michaelyoyo/piDashHat/dashHat.kicad_pcb

## KiCad design dashHat.kicad_pcb (2024-06-26)

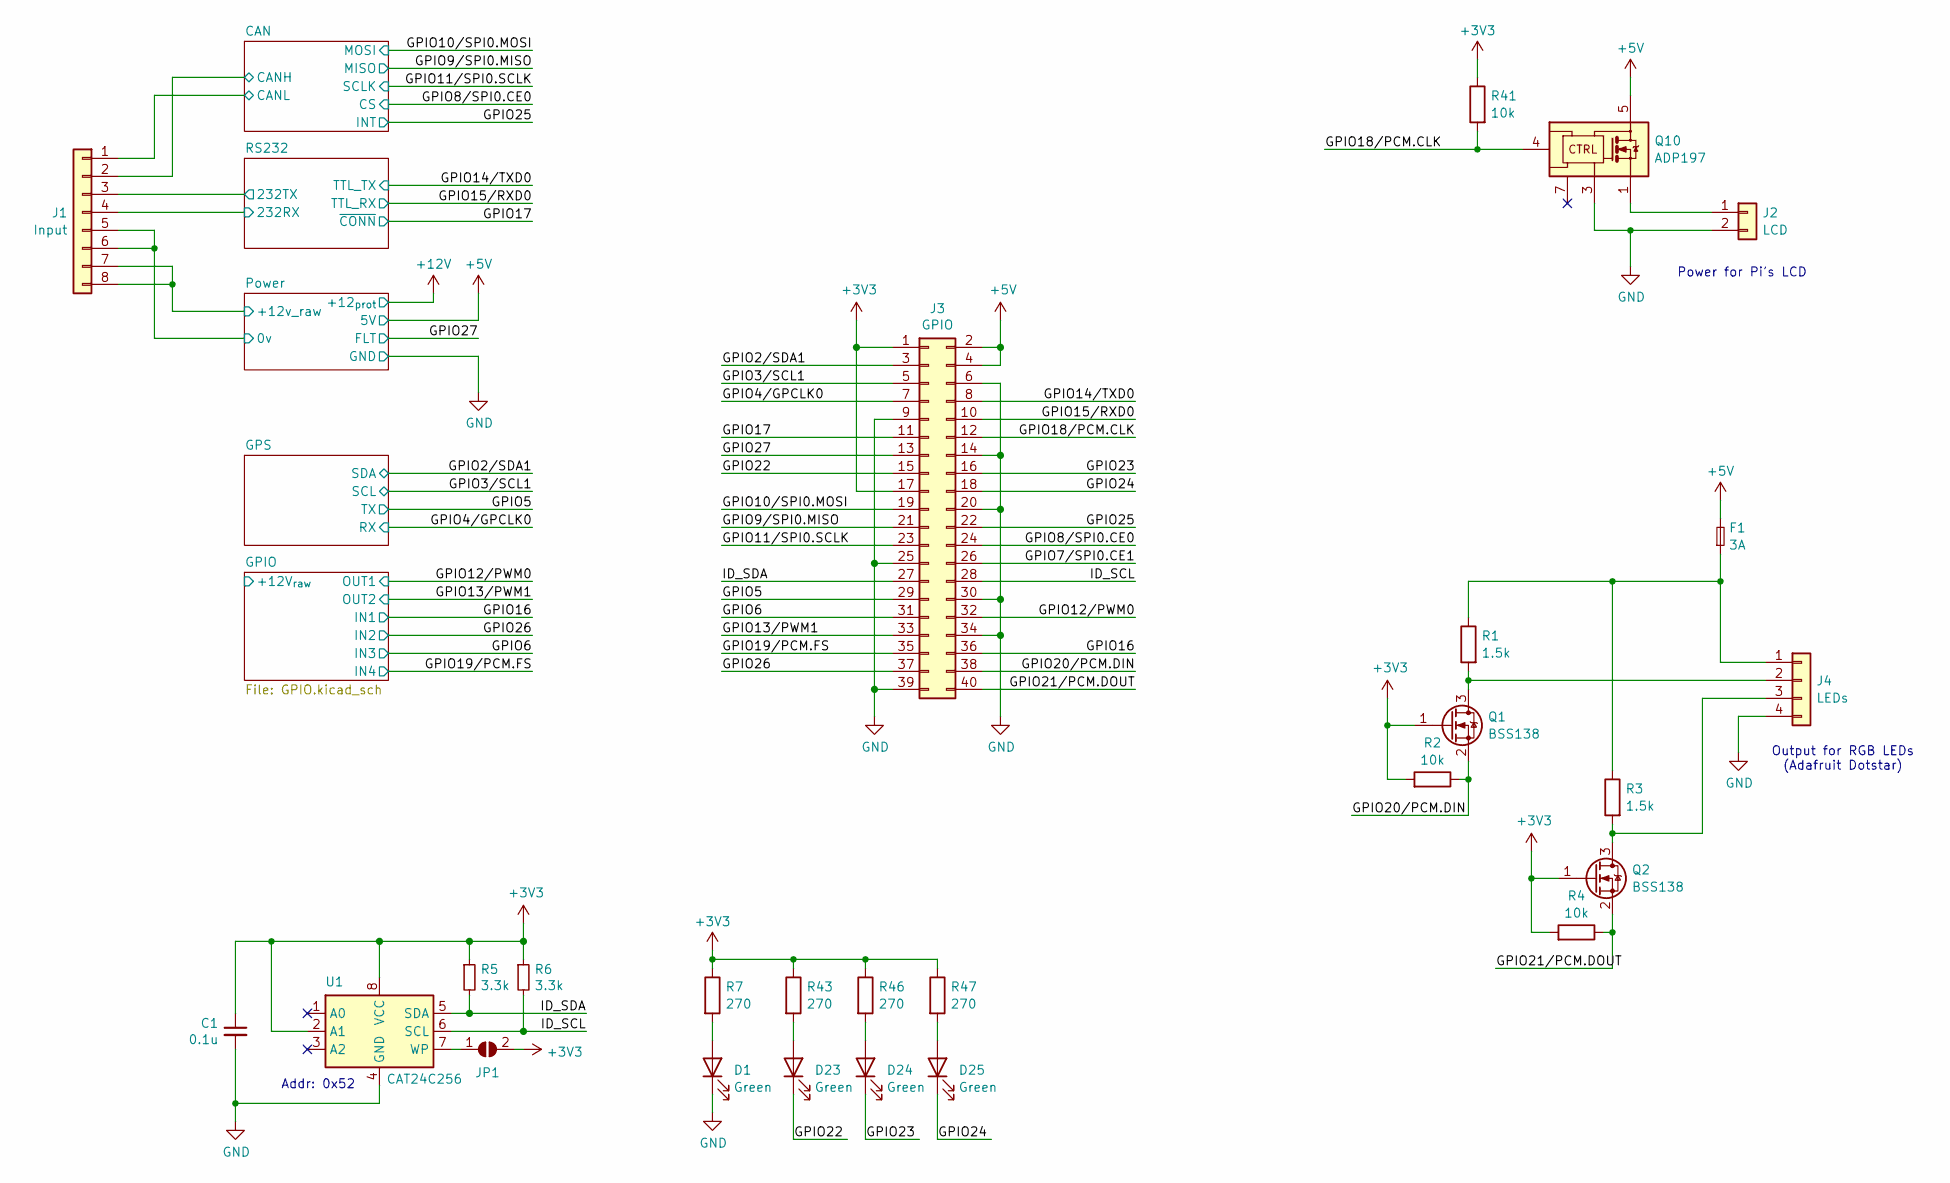
[picture p1: schematic dashHat.kicad_sch, PiDash HAT]

Parts:
C1: 0.1u; C_0603_1608Metric; Mfg Part Number CGA3E2X8R1E104K080AA
D1, D23, D24, D25: Green; LED_0603_1608Metric; Mfg Part Number HSMG-C190
F1: 3A; Fuse_1812_4532Metric; Mfg Part Number 0ZCG0260BF2B
J1: Input; Molex_Nano-Fit_105310-xx08_2x04_P2.50mm_Vertical; Mfg Part Number 105310-1108
J2: LCD; JST_XH_B2B-XH-A_1x02_P2.50mm_Vertical; Mfg Part Number --
J3: GPIO; PinSocket_2x20_P2.54mm_Vertical; Mfg Part Number SSQ-120-01-F-D
J4: LEDs; Molex_Nano-Fit_105310-xx04_2x02_P2.50mm_Vertical; Mfg Part Number 105310-1104
JP1: ID_WP; SolderJumper-2_P1.3mm_Open_RoundedPad1.0x1.5mm; Mfg Part Number --
Q1, Q2: BSS138; SOT-23; Mfg Part Number BSS138
Q10: ADP197; DFN-6-1EP_2x2mm_P0.65mm_EP1x1.6mm; Mfg Part Number ADP197ACPZN-01-R7
R1, R3: 1.5k; R_0603_1608Metric
R2, R4, R41: 10k; R_0603_1608Metric
R5, R6: 3.3k; R_0603_1608Metric
R7, R43, R46, R47: 270; R_0603_1608Metric
U1: CAT24C256; DFN-8-1EP_3x2mm_P0.5mm_EP1.36x1.46mm; Mfg Part Number CAT24C256HU4IGT3

Connections:
+3V3: C1.1, J3.1, J3.17, JP1.2 (B), Q1.1 (G), Q2.1 (G), R2.2, R4.2, R5.1, R6.1, R7.1, R41.1, R43.1, R46.1, R47.1, U1.2 (A1), U1.8 (VCC); also elsewhere on the board
+5V: F1.2, J3.2, J3.4, Q10.5 (VCC), Q10.6 (VCC); also elsewhere on the board
/CAN/CANH: J1.2; also elsewhere on the board
/CAN/CANL: J1.1; also elsewhere on the board
/GPIO2/SDA1: J3.3; also elsewhere on the board
/GPIO3/SCL1: J3.5; also elsewhere on the board
/GPIO4/GPCLK0: J3.7; also elsewhere on the board
/GPIO5: J3.29; also elsewhere on the board
/GPIO6: J3.31; also elsewhere on the board
/GPIO7/SPI0.CE1: J3.26
/GPIO8/SPI0.CE0: J3.24; also elsewhere on the board
/GPIO9/SPI0.MISO: J3.21; also elsewhere on the board
/GPIO10/SPI0.MOSI: J3.19; also elsewhere on the board
/GPIO11/SPI0.SCLK: J3.23; also elsewhere on the board
/GPIO12/PWM0: J3.32; also elsewhere on the board
/GPIO13/PWM1: J3.33; also elsewhere on the board
/GPIO14/TXD0: J3.8; also elsewhere on the board
/GPIO15/RXD0: J3.10; also elsewhere on the board
/GPIO16: J3.36; also elsewhere on the board
/GPIO17: J3.11; also elsewhere on the board
/GPIO18/PCM.CLK: J3.12, Q10.4 (EN), R41.2
/GPIO19/PCM.FS: J3.35; also elsewhere on the board
/GPIO20/PCM.DIN: J3.38, Q1.2 (S), R2.1
/GPIO21/PCM.DOUT: J3.40, Q2.2 (S), R4.1
/GPIO22: D23.1 (K), J3.15
/GPIO23: D24.1 (K), J3.16
/GPIO24: D25.1 (K), J3.18
/GPIO25: J3.22; also elsewhere on the board
/GPIO26: J3.37; also elsewhere on the board
/GPIO27: J3.13; also elsewhere on the board
/ID_SCL: J3.28, R6.2, U1.6 (SCL)
/ID_SDA: J3.27, R5.2, U1.5 (SDA)
/Power/+12v_raw: J1.7, J1.8; also elsewhere on the board
/RS232/232RX: J1.4; also elsewhere on the board
/RS232/232TX: J1.3; also elsewhere on the board
GND: C1.2, D1.1 (K), J1.5, J1.6, J2.2, J3.6, J3.9, J3.14, J3.20, J3.25, J3.30, J3.34, J3.39, J4.4, Q10.3 (GND), U1.4 (GND); also elsewhere on the board
unnamed: D1.2 (A), R7.2
unnamed: D23.2 (A), R43.2
unnamed: D24.2 (A), R46.2
unnamed: D25.2 (A), R47.2
unnamed: J2.1, Q10.1 (OUT), Q10.2 (OUT)
unnamed: F1.1, J4.1, R1.1, R3.1
unnamed: J4.2, Q1.3 (D), R1.2
unnamed: J4.3, Q2.3 (D), R3.2
unnamed: JP1.1 (A), U1.7 (WP)

Notes on the sheet:
Output for RGB LEDs (Adafruit Dotstar)
Addr: 0x52
Power for Pi's LCD

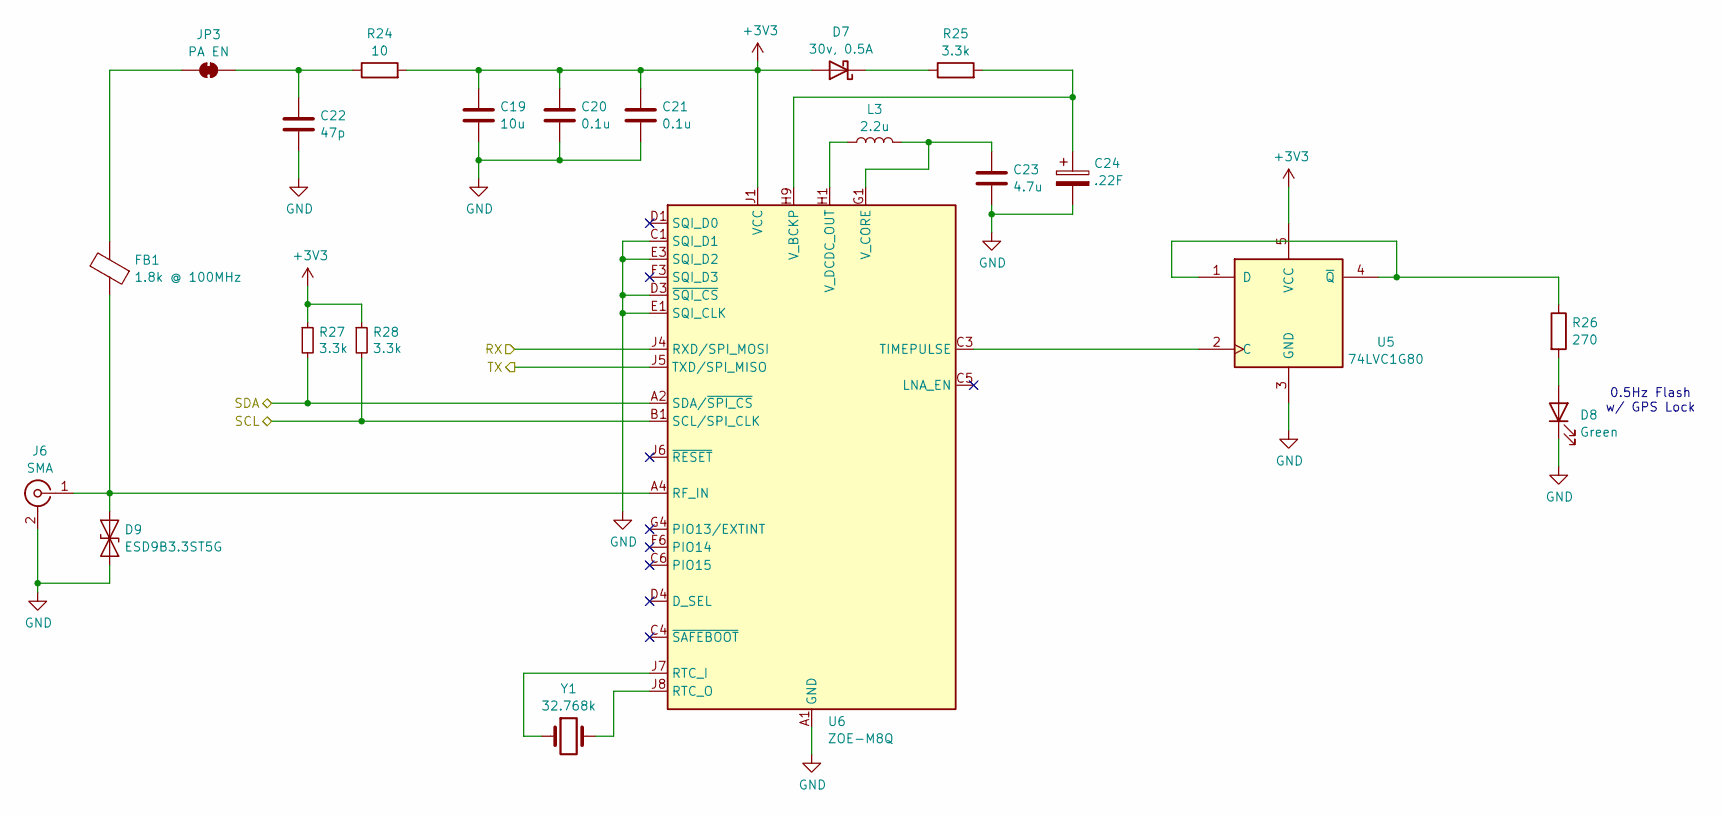
[picture p2: schematic gps.kicad_sch, PiDash HAT]

Parts:
C19: 10u; C_1206_3216Metric; Mfg Part Number CGA5L1X7R1C106K160AC
C20, C21: 0.1u; C_0603_1608Metric; Mfg Part Number CGA3E2X8R1E104K080AA
C22: 47p; C_0603_1608Metric; Mfg Part Number C0603C470K5RACAUTO
C23: 4.7u; C_0603_1608Metric; Mfg Part Number GCJ188C70J475KE02D
C24: .22F; DX_5R5HxxxxU_D11.5mm_P10.00mm; Mfg Part Number EDS224Z3R6H
D7: 30v, 0.5A; D_SOD-323HE; Mfg Part Number RSX051VYM30FHTR
D8: Green; LED_0603_1608Metric; Mfg Part Number HSMG-C190
D9: ESD9B3.3ST5G; D_SOD-923; Mfg Part Number ESD9R3.3ST5G
FB1: 1.8k @ 100MHz; L_0402_1005Metric; Mfg Part Number BLM15HD182SN1D
J6: SMA; SMA_Amphenol_132289_EdgeMount; Mfg Part Number 132289
JP3: PA EN; SolderJumper-2_P1.3mm_Open_RoundedPad1.0x1.5mm; Mfg Part Number --
L3: 2.2u; L_0806_2016Metric; Mfg Part Number LQM2MPN2R2NG0L
R24: 10; R_0603_1608Metric
R25, R27, R28: 3.3k; R_0603_1608Metric
R26: 270; R_0603_1608Metric
U5: 74LVC1G80; SOT-353_SC-70-5; Mfg Part Number 74LVC1G80GW,125
U6: ZOE-M8Q; ublox_ZOE_M8; Mfg Part Number ZOE-M8Q-0
Y1: 32.768k; Crystal_SMD_2012-2Pin_2.0x1.2mm; Mfg Part Number CM8V-T1A-32.768kHz-12.5pF-20PPM-TA-QC

Connections:
+3V3: C19.1, C20.1, C21.1, D7.2 (A), R24.2, R27.1, R28.1, U5.5 (VCC), U6.J1 (VCC), U6.J2 (VCC); also elsewhere on the board
/GPIO2/SDA1: R27.2, U6.A2 (SDA/~SPI_CS); also elsewhere on the board
/GPIO3/SCL1: R28.2, U6.B1 (SCL/SPI_CLK); also elsewhere on the board
/GPIO4/GPCLK0: U6.J4 (RXD/SPI_MOSI); also elsewhere on the board
/GPIO5: U6.J5 (TXD/SPI_MISO); also elsewhere on the board
GND: C19.2, C20.2, C21.2, C22.2, C23.2, C24.2, D8.1 (K), D9.1 (A1), J6.2 (Ext), U5.3 (GND), U6.A1 (GND), U6.A3 (GND), U6.A5 (GND), U6.A7 (GND), U6.A8 (GND), U6.A9 (GND), U6.B9 (GND), U6.C1 (SQI_D1), U6.C7 (GND), U6.C9 (GND), U6.D3 (~SQI_CS), U6.D6 (GND), U6.D9 (GND), U6.E1 (SQI_CLK), U6.E3 (SQI_D2), U6.E7 (GND), U6.F7 (GND), U6.G3 (GND), U6.G6 (GND), U6.G7 (GND), U6.J3 (GND), U6.J9 (GND); also elsewhere on the board
unnamed: D7.1 (K), R25.1
unnamed: D8.2 (A), R26.2
unnamed: D9.2 (A2), FB1.1, J6.1 (In), U6.A4 (RF_IN)
unnamed: C22.1, JP3.1 (A), R24.1
unnamed: FB1.2, JP3.2 (B)
unnamed: U5.2 (C), U6.C3 (TIMEPULSE)
unnamed: R26.1, U5.1 (D), U5.4 (~Q)
unnamed: U6.J7 (RTC_I), Y1.1
unnamed: U6.J8 (RTC_O), Y1.2
unnamed: C24.1, R25.2, U6.H9 (V_BCKP)
unnamed: C23.1, L3.2, U6.G1 (V_CORE)
unnamed: L3.1, U6.H1 (V_DCDC_OUT)

Notes on the sheet:
0.5Hz Flash w/ GPS Lock

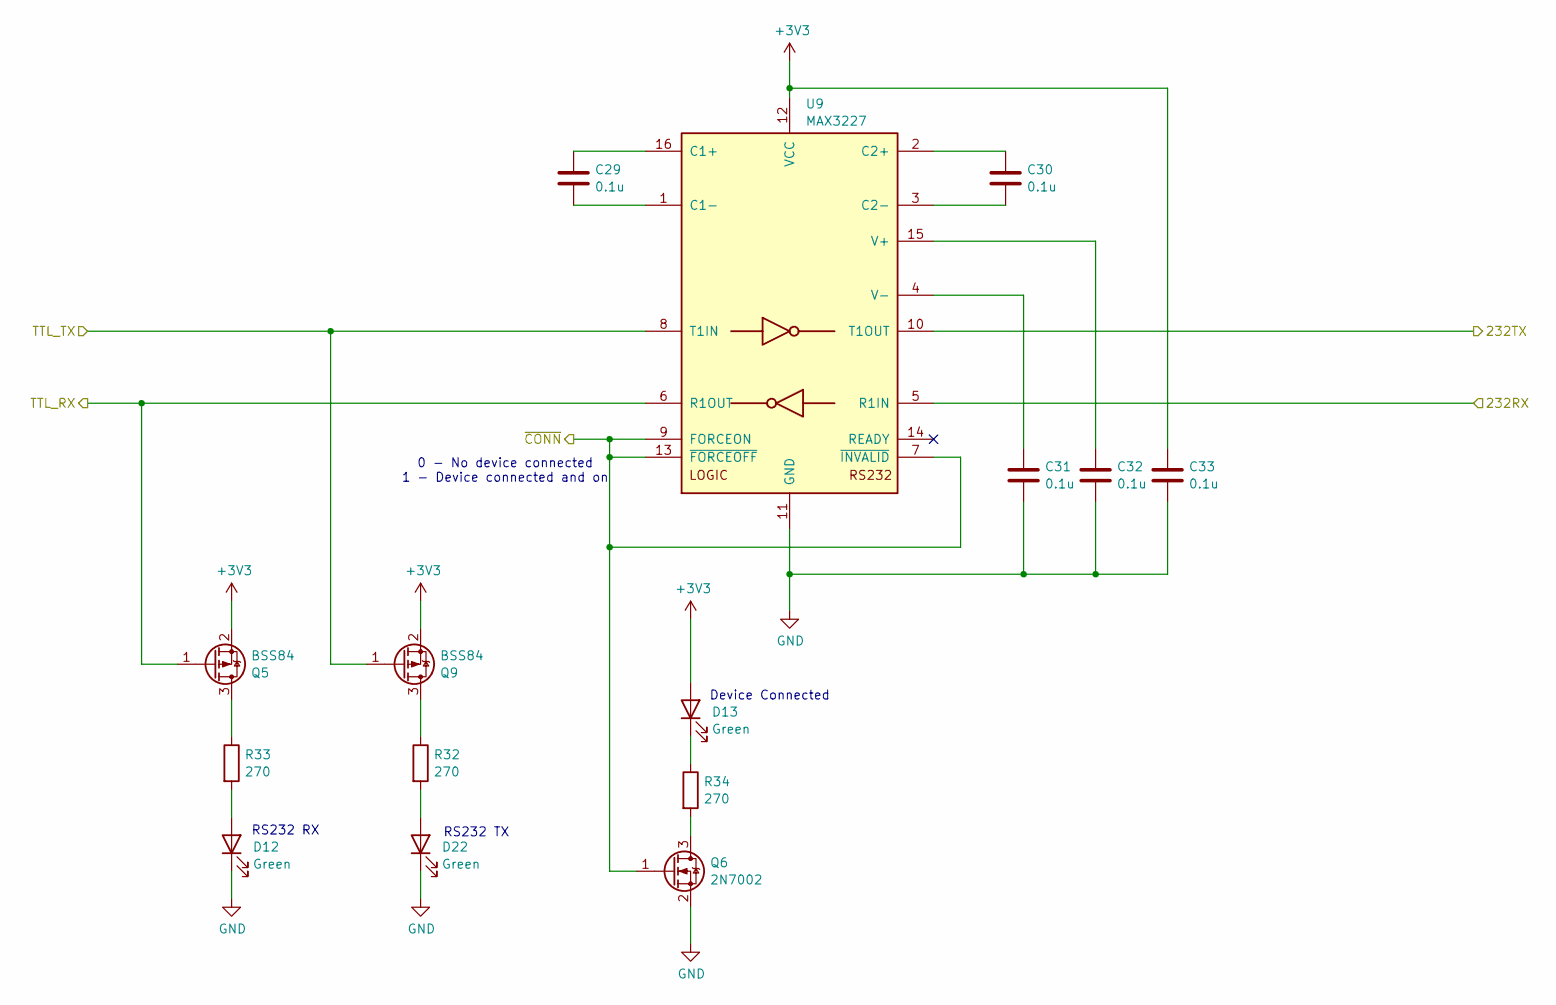
[picture p3: schematic RS232.kicad_sch, PiDash HAT]

Parts:
C29, C30, C31, C32, C33: 0.1u; C_0603_1608Metric; Mfg Part Number CGA3E2X8R1E104K080AA
D12, D13, D22: Green; LED_0603_1608Metric; Mfg Part Number HSMG-C190
Q5, Q9: BSS84; SOT-23; Mfg Part Number BSS84
Q6: 2N7002; SOT-23; Mfg Part Number 2N7002
R32, R33, R34: 270; R_0603_1608Metric
U9: MAX3227; QFN-16-1EP_5x5mm_P0.8mm_EP2.7x2.7mm; Mfg Part Number MAX3226EETE+

Connections:
+3V3: C33.1, D13.2 (A), Q5.2 (S), Q9.2 (S), U9.12 (VCC); also elsewhere on the board
/GPIO14/TXD0: Q9.1 (G), U9.8 (T1IN); also elsewhere on the board
/GPIO15/RXD0: Q5.1 (G), U9.6 (R1OUT); also elsewhere on the board
/GPIO17: Q6.1 (G), U9.7 (~INVALID), U9.9 (FORCEON), U9.13 (~FORCEOFF); also elsewhere on the board
/RS232/232RX: U9.5 (R1IN); also elsewhere on the board
/RS232/232TX: U9.10 (T1OUT); also elsewhere on the board
GND: C31.2, C32.2, C33.2, D12.1 (K), D22.1 (K), Q6.2 (S), U9.11 (GND); also elsewhere on the board
unnamed: D12.2 (A), R33.2
unnamed: D13.1 (K), R34.1
unnamed: D22.2 (A), R32.2
unnamed: Q5.3 (D), R33.1
unnamed: Q6.3 (D), R34.2
unnamed: Q9.3 (D), R32.1
unnamed: C29.1, U9.16 (C1+)
unnamed: C29.2, U9.1 (C1-)
unnamed: C30.1, U9.2 (C2+)
unnamed: C30.2, U9.3 (C2-)
unnamed: C32.1, U9.15 (V+)
unnamed: C31.1, U9.4 (V-)

Notes on the sheet:
RS232 TX
0 - No device connected 1 - Device connected and on
RS232 RX
Device Connected

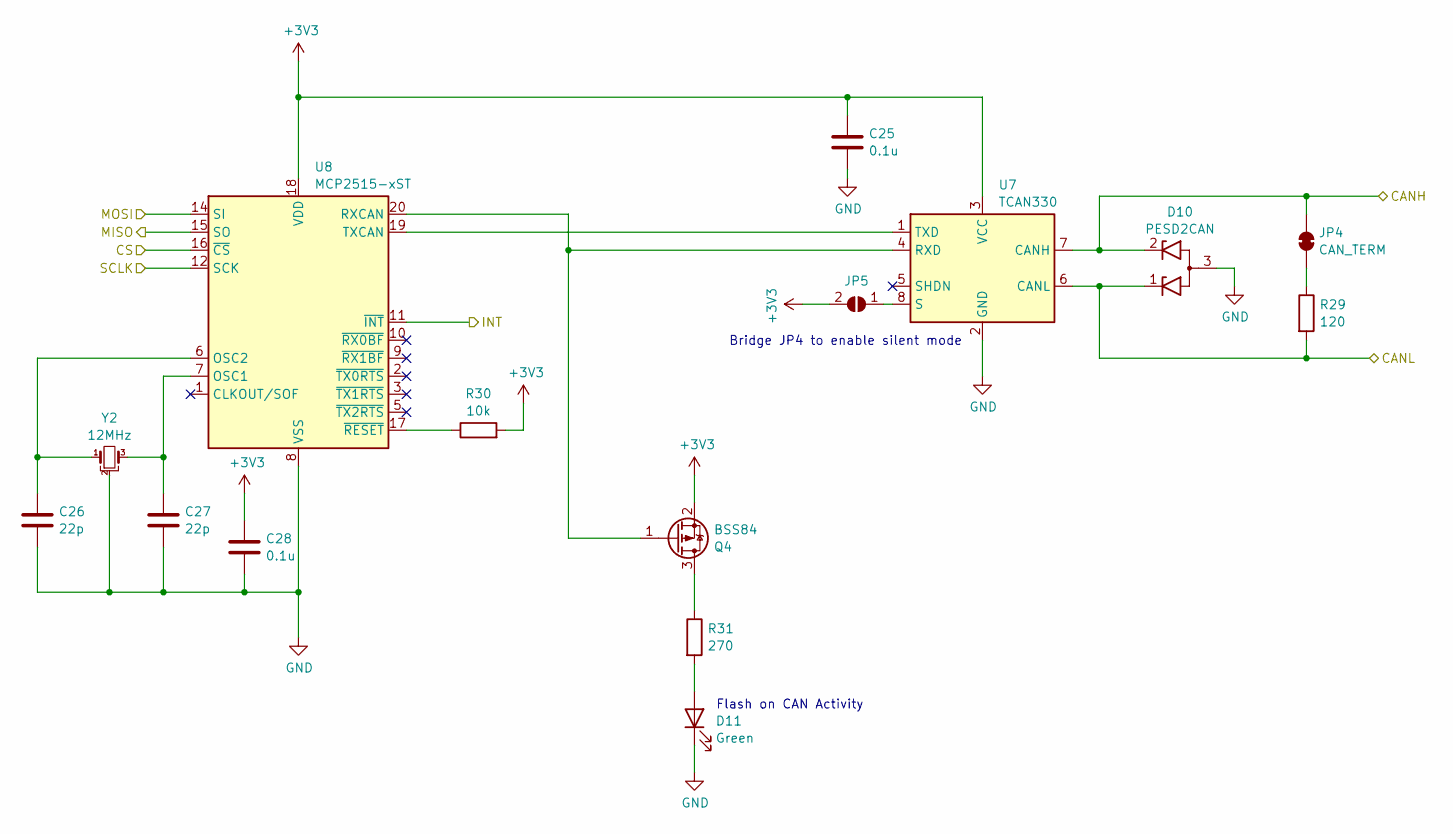
[picture p4: schematic can.kicad_sch, PiDash HAT]

Parts:
C25, C28: 0.1u; C_0603_1608Metric; Mfg Part Number CGA3E2X8R1E104K080AA
C26, C27: 22p; C_0603_1608Metric; Mfg Part Number VJ0603A220KXAAC
D10: PESD2CAN; SOT-23; Mfg Part Number PESD2CANFD36VT-QR
D11: Green; LED_0603_1608Metric; Mfg Part Number HSMG-C190
JP4: CAN_TERM; SolderJumper-2_P1.3mm_Bridged_RoundedPad1.0x1.5mm; Mfg Part Number --
JP5: CAN_SILENT; SolderJumper-2_P1.3mm_Open_RoundedPad1.0x1.5mm; Mfg Part Number --
Q4: BSS84; SOT-23; Mfg Part Number BSS84
R29: 120; R_0603_1608Metric
R30: 10k; R_0603_1608Metric
R31: 270; R_0603_1608Metric
U7: TCAN330; SOT-23-8; Mfg Part Number TCAN330DCNR
U8: MCP2515-xST; QFN-20-1EP_4x4mm_P0.5mm_EP2.7x2.7mm; Mfg Part Number MCP2515-I/ML
Y2: 12MHz; Crystal_SMD_3225-4Pin_3.2x2.5mm; Mfg Part Number FL1200112

Connections:
+3V3: C25.1, C28.1, JP5.2 (B), Q4.2 (S), R30.2, U7.3 (VCC), U8.18 (VDD); also elsewhere on the board
/CAN/CANH: D10.2 (K2), JP4.2 (B), U7.7 (CANH); also elsewhere on the board
/CAN/CANL: D10.1 (K1), R29.2, U7.6 (CANL); also elsewhere on the board
/GPIO8/SPI0.CE0: U8.16 (~CS); also elsewhere on the board
/GPIO9/SPI0.MISO: U8.15 (SO); also elsewhere on the board
/GPIO10/SPI0.MOSI: U8.14 (SI); also elsewhere on the board
/GPIO11/SPI0.SCLK: U8.12 (SCK); also elsewhere on the board
/GPIO25: U8.11 (~INT); also elsewhere on the board
GND: C25.2, C26.2, C27.2, C28.2, D10.3 (A), D11.1 (K), U7.2 (GND), U8.8 (VSS), U8.21 (EP), Y2.2; also elsewhere on the board
unnamed: D11.2 (A), R31.2
unnamed: JP4.1 (A), R29.1
unnamed: JP5.1 (A), U7.8 (S)
unnamed: Q4.3 (D), R31.1
unnamed: Q4.1 (G), U7.4 (RXD), U8.20 (RXCAN)
unnamed: U7.1 (TXD), U8.19 (TXCAN)
unnamed: C27.1, U8.7 (OSC1), Y2.3
unnamed: C26.1, U8.6 (OSC2), Y2.1
unnamed: R30.1, U8.17 (~RESET)

Notes on the sheet:
Flash on CAN Activity
Bridge JP4 to enable silent mode

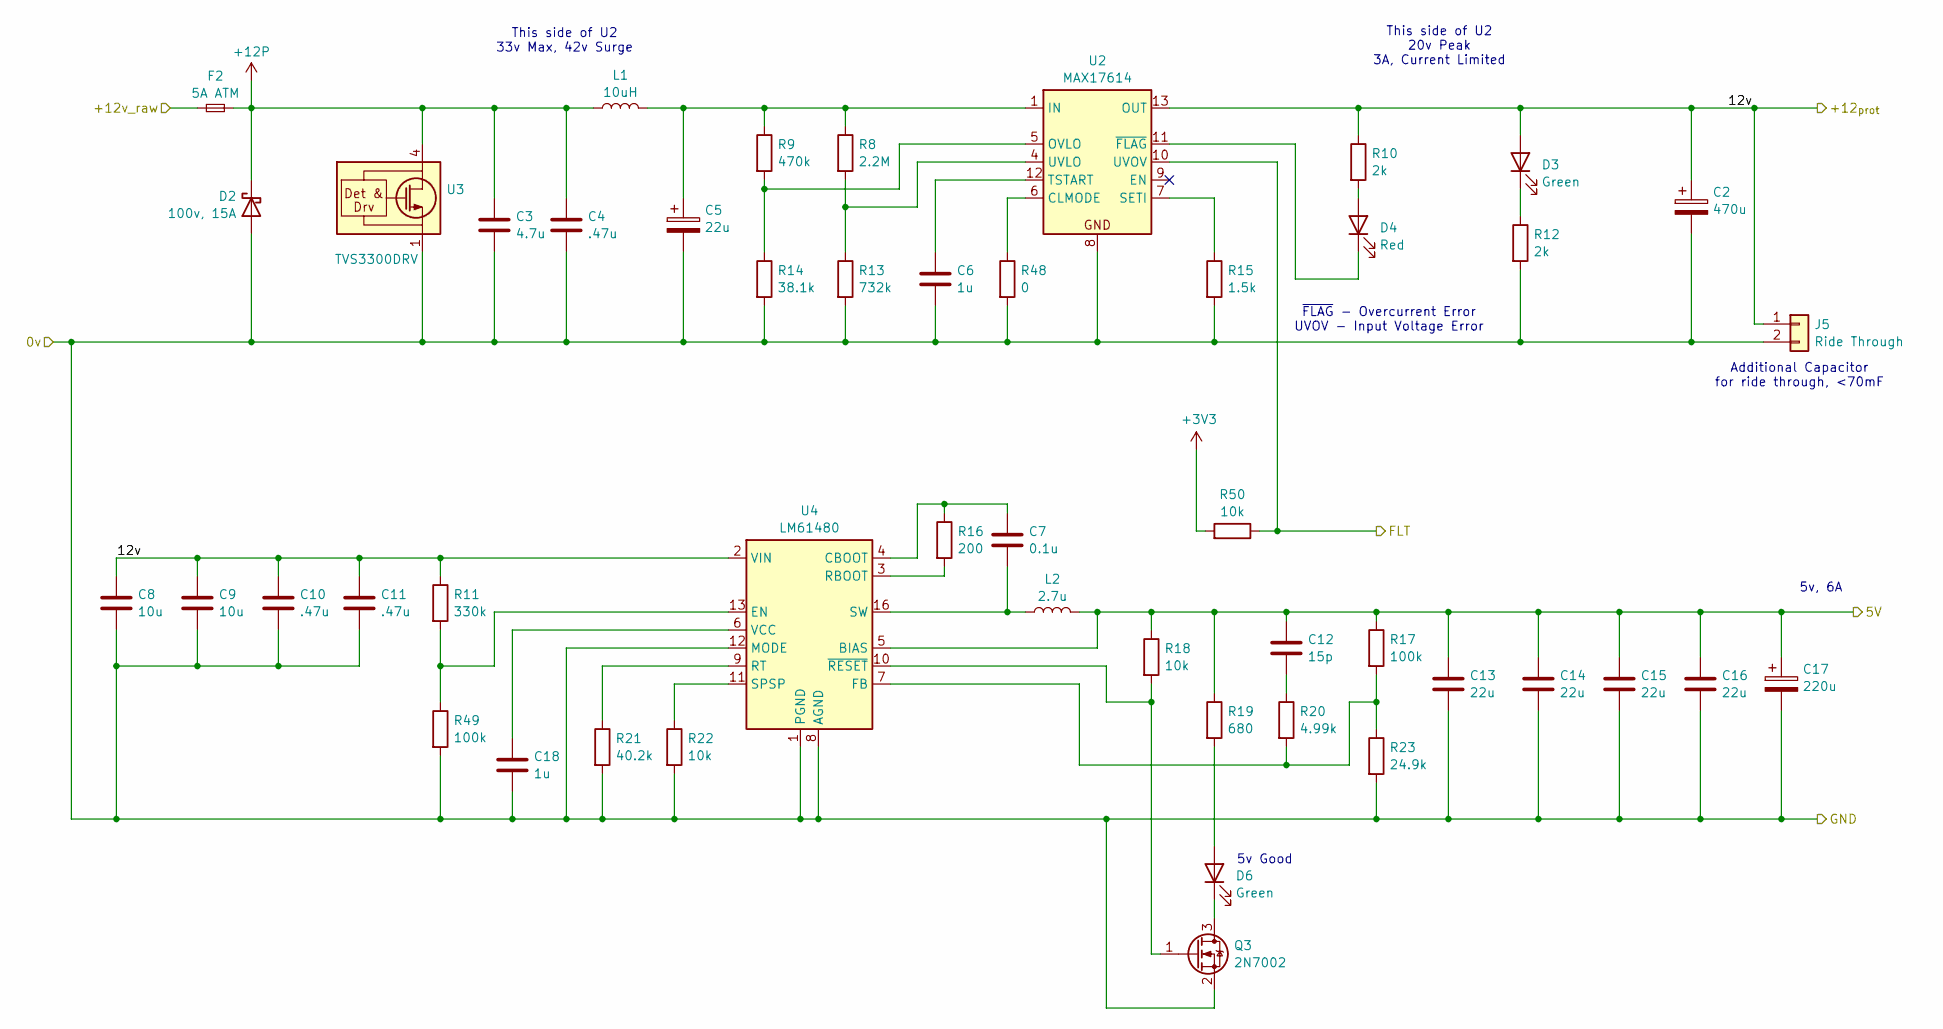
[picture p5: schematic power.kicad_sch, PiDash HAT]

Parts:
C2: 470u; CP_Radial_D8.0mm_P3.50mm; Mfg Part Number EEU-FR1C471
C3: 4.7u; C_1206_3216Metric; Mfg Part Number CGA5L3X7R1H475K160AE
C4, C10, C11: .47u; C_0805_2012Metric; Mfg Part Number GCM21BR71H474KA55K
C5: 22u; CP_Radial_D5.0mm_P2.00mm; Mfg Part Number EEA-GA1C220H
C6: 1u; C_0603_1608Metric; Mfg Part Number 06035C104K4Z2A
C7: 0.1u; C_0603_1608Metric; Mfg Part Number CGA3E2X8R1E104K080AA
C8, C9: 10u; C_1210_3225Metric; Mfg Part Number UMK325AB7106KM-T
C12: 15p; C_0603_1608Metric; Mfg Part Number C0603C150K5RACAUTO
C13, C14, C15, C16: 22u; C_1210_3225Metric; Mfg Part Number CGA6P3X7R1E226M250AE
C17: 220u; CP_Radial_D6.3mm_P2.50mm; Mfg Part Number 860240273005
C18: 1u; C_0603_1608Metric; Mfg Part Number MSAST168SB7105KTNA01
D2: 100v, 15A; TO-277A; Mfg Part Number YQ15RSM10SDTL1
D3, D6: Green; LED_0603_1608Metric; Mfg Part Number HSMG-C190
D4: Red; LED_0603_1608Metric; Mfg Part Number HSMS-C190
F2: 5A ATM; Fuseholder_Blade_Mini_Keystone_3568; Mfg Part Number 3568
J5: Ride Through; JST_PH_B2B-PH-K_1x02_P2.00mm_Vertical; Mfg Part Number --
L1: 10uH; L_Coilcraft_XxL4030; Mfg Part Number XGL4030-103MEC
L2: 2.7u; L_Coilcraft_XAL7030-272; Mfg Part Number XAL7030-272MEC
Q3: 2N7002; SOT-23; Mfg Part Number 2N7002
R8: 2.2M; R_0603_1608Metric
R9: 470k; R_0603_1608Metric
R10, R12: 2k; R_0603_1608Metric
R11: 330k; R_0603_1608Metric
R13: 732k; R_0603_1608Metric
R14: 38.1k; R_0603_1608Metric
R15: 1.5k; R_0603_1608Metric
R16: 200; R_0603_1608Metric
R17, R49: 100k; R_0603_1608Metric
R18, R22, R50: 10k; R_0603_1608Metric
R19: 680; R_0603_1608Metric
R20: 4.99k; R_0603_1608Metric
R21: 40.2k; R_0603_1608Metric
R23: 24.9k; R_0603_1608Metric
R48: 0; R_0603_1608Metric
U2: MAX17614; TQFN-20-1EP_4x4mm_P0.5mm_EP2.9x2.9mm_ThermalVias; Mfg Part Number MAX17614ATP+
U3: TVS3300DRV; WSON-6-1EP_2x2mm_P0.65mm_EP1x1.6mm; Mfg Part Number TVS3300DRVR
U4: LM61480; LM6x4xx Buck Converter; Mfg Part Number LM61480RPHR

Connections:
+3V3: R50.2; also elsewhere on the board
+5V: C12.2, C13.1, C14.1, C15.1, C16.1, C17.1, L2.2, R17.1, R18.1, R19.1, U4.5 (BIAS); also elsewhere on the board
+12P: C3.1, C4.1, D2.1 (K), F2.2, L1.1, U3.4 (IN), U3.5 (IN), U3.6 (IN); also elsewhere on the board
+12V: C2.1, C8.1, C9.1, C10.1, C11.1, D3.2 (A), J5.1, R10.1, R11.1, U2.13 (OUT), U2.14 (OUT), U2.15 (OUT), U4.2 (VIN), U4.14 (VIN); also elsewhere on the board
/GPIO27: R50.1, U2.10 (UVOV); also elsewhere on the board
/Power/+12v_raw: F2.1; also elsewhere on the board
GND: C2.2, C3.2, C4.2, C5.2, C6.2, C8.2, C9.2, C10.2, C11.2, C13.2, C14.2, C15.2, C16.2, C17.2, C18.2, D2.2 (A), J5.2, Q3.2 (S), R12.2, R13.2, R14.2, R15.2, R21.2, R22.2, R23.2, R48.2, R49.2, U2.8, U2.21 (EP), U3.1 (GND), U3.2 (GND), U3.3 (GND), U3.7 (GND), U4.1 (PGND), U4.8 (AGND), U4.12 (MODE), U4.15 (PGND); also elsewhere on the board
IN: C5.1, L1.2, R8.1, R9.1, U2.1 (IN), U2.2 (IN), U2.3 (IN)
unnamed: C12.1, R20.1
unnamed: D3.1 (K), R12.1
unnamed: D4.2 (A), R10.2
unnamed: D4.1 (K), U2.11 (~FLAG)
unnamed: D6.2 (A), R19.2
unnamed: D6.1 (K), Q3.3 (D)
unnamed: Q3.1 (G), R18.2, U4.10 (~RESET)
unnamed: R48.1, U2.6 (CLMODE)
unnamed: R9.2, R14.1, U2.5 (OVLO)
unnamed: R15.1, U2.7 (SETI)
unnamed: C6.1, U2.12 (TSTART)
unnamed: R8.2, R13.1, U2.4 (UVLO)
unnamed: C7.1, R16.1, U4.4 (CBOOT)
unnamed: R11.2, R49.1, U4.13 (EN)
unnamed: R17.2, R20.2, R23.1, U4.7 (FB)
unnamed: R16.2, U4.3 (RBOOT)
unnamed: R21.1, U4.9 (RT)
unnamed: R22.1, U4.11 (SPSP)
unnamed: C7.2, L2.1, U4.16 (SW)
unnamed: C18.1, U4.6 (VCC)

Notes on the sheet:
This side of U2 33v Max, 42v Surge
5v, 6A
Additional Capacitor for ride through, <70mF
This side of U2 20v Peak 3A, Current Limited
~{FLAG} - Overcurrent Error UVOV - Input Voltage Error
5v Good

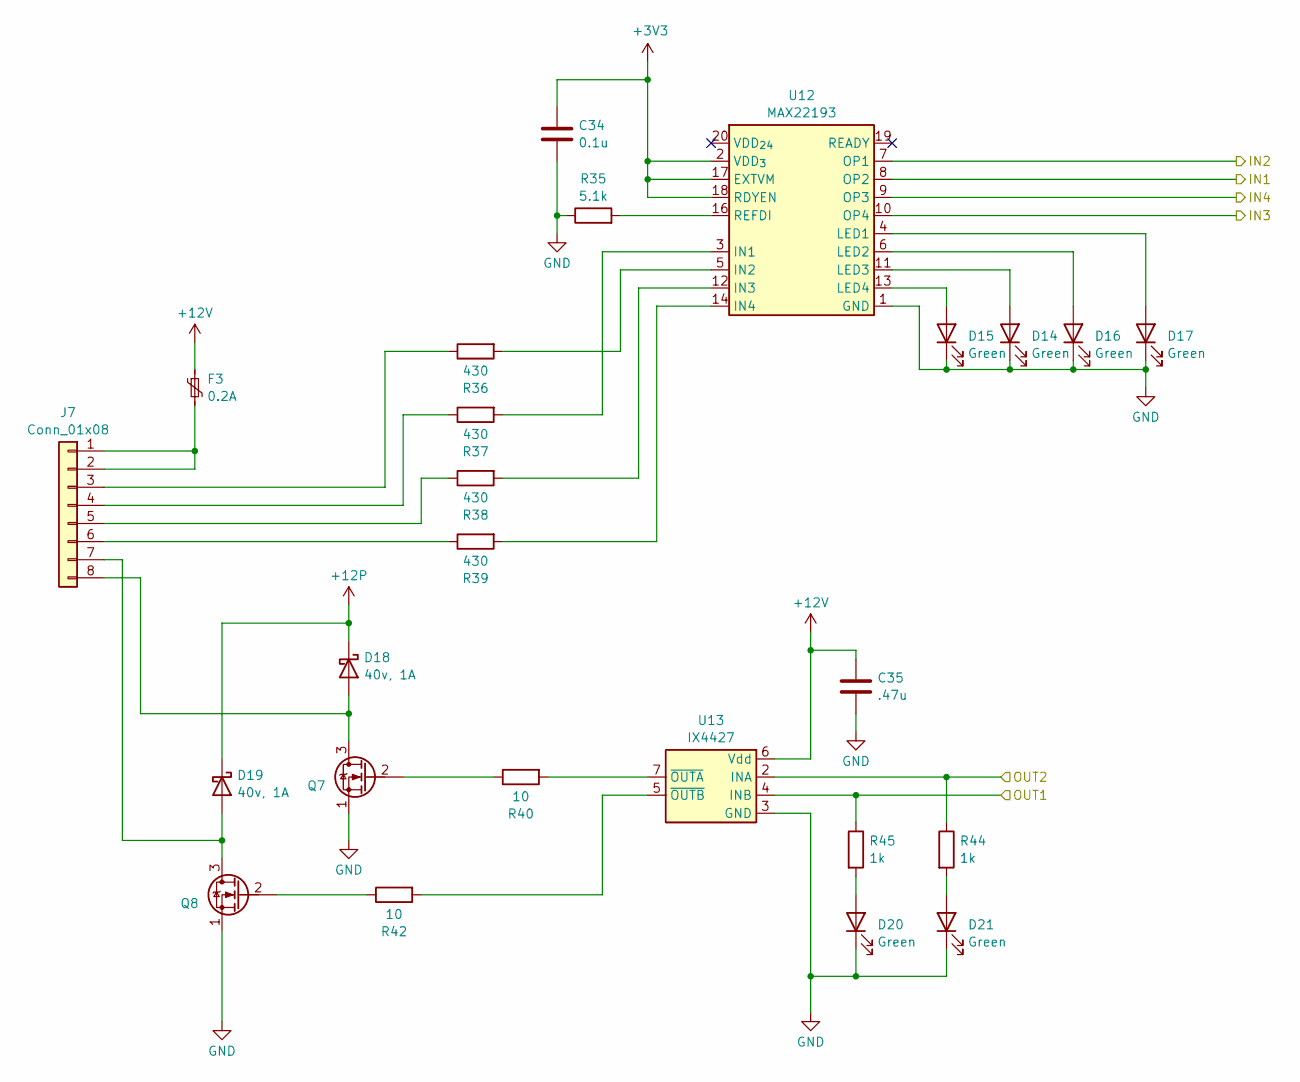
[picture p6: schematic GPIO.kicad_sch, PiDash HAT]

Parts:
C34: 0.1u; C_0603_1608Metric; Mfg Part Number CGA3E2X8R1E104K080AA
C35: .47u; C_0805_2012Metric; Mfg Part Number GCM21BR71H474KA55K
D14, D15, D16, D17, D20, D21: Green; LED_0603_1608Metric; Mfg Part Number HSMG-C190
D18, D19: 40v, 1A; D_SOD-323F; Mfg Part Number PMEG4010EJ,115
F3: 0.2A; Fuse_1812_4532Metric; Mfg Part Number MINISMDC020F-2
J7: Conn_01x08; Molex_Nano-Fit_105309-xx08_1x08_P2.50mm_Vertical; Mfg Part Number 105309-1208
Q7, Q8: Infineon_PG-TDSON-8_6.15x5.15mm; Mfg Part Number SIRA54ADP-T1-RE3
R35: 5.1k; R_0603_1608Metric
R36, R37, R38, R39: 430; R_0603_1608Metric
R40, R42: 10; R_0603_1608Metric
R44, R45: 1k; R_0603_1608Metric
U12: MAX22193; TQFN-20-1EP_4x4mm_P0.5mm_EP2.1x2.1mm; Mfg Part Number MAX22193ATP+
U13: IX4427; DFN-8-1EP_3x3mm_P0.65mm_EP1.7x2.05mm; Mfg Part Number IX4427MTR

Connections:
+3V3: C34.1, U12.2 (VDD_{3}), U12.17 (EXTVM), U12.18 (RDYEN); also elsewhere on the board
+12P: D18.1 (K), D19.1 (K); also elsewhere on the board
+12V: C35.1, F3.1, U13.6 (Vdd); also elsewhere on the board
/GPIO6: U12.10 (OP4); also elsewhere on the board
/GPIO12/PWM0: R45.1, U13.4 (INB); also elsewhere on the board
/GPIO13/PWM1: R44.1, U13.2 (INA); also elsewhere on the board
/GPIO16: U12.8 (OP2); also elsewhere on the board
/GPIO19/PCM.FS: U12.9 (OP3); also elsewhere on the board
/GPIO26: U12.7 (OP1); also elsewhere on the board
GND: C34.2, C35.2, D14.1 (K), D15.1 (K), D16.1 (K), D17.1 (K), D20.1 (K), D21.1 (K), Q7.1 (S), Q8.1 (S), R35.1, U12.1 (GND), U12.15 (GND), U12.21 (GND), U13.3 (GND); also elsewhere on the board
unnamed: D14.2 (A), U12.11 (LED3)
unnamed: D15.2 (A), U12.13 (LED4)
unnamed: D16.2 (A), U12.6 (LED2)
unnamed: D17.2 (A), U12.4 (LED1)
unnamed: D18.2 (A), J7.8, Q7.3 (D)
unnamed: D19.2 (A), J7.7, Q8.3 (D)
unnamed: D20.2 (A), R45.2
unnamed: D21.2 (A), R44.2
unnamed: F3.2, J7.1, J7.2
unnamed: J7.3, R36.1
unnamed: J7.4, R37.1
unnamed: J7.5, R38.1
unnamed: J7.6, R39.1
unnamed: Q7.2 (G), R40.1
unnamed: Q8.2 (G), R42.1
unnamed: R37.2, U12.3 (IN1)
unnamed: R36.2, U12.5 (IN2)
unnamed: R38.2, U12.12 (IN3)
unnamed: R39.2, U12.14 (IN4)
unnamed: R35.2, U12.16 (REFDI)
unnamed: R40.2, U13.7 (~OUTA)
unnamed: R42.2, U13.5 (~OUTB)

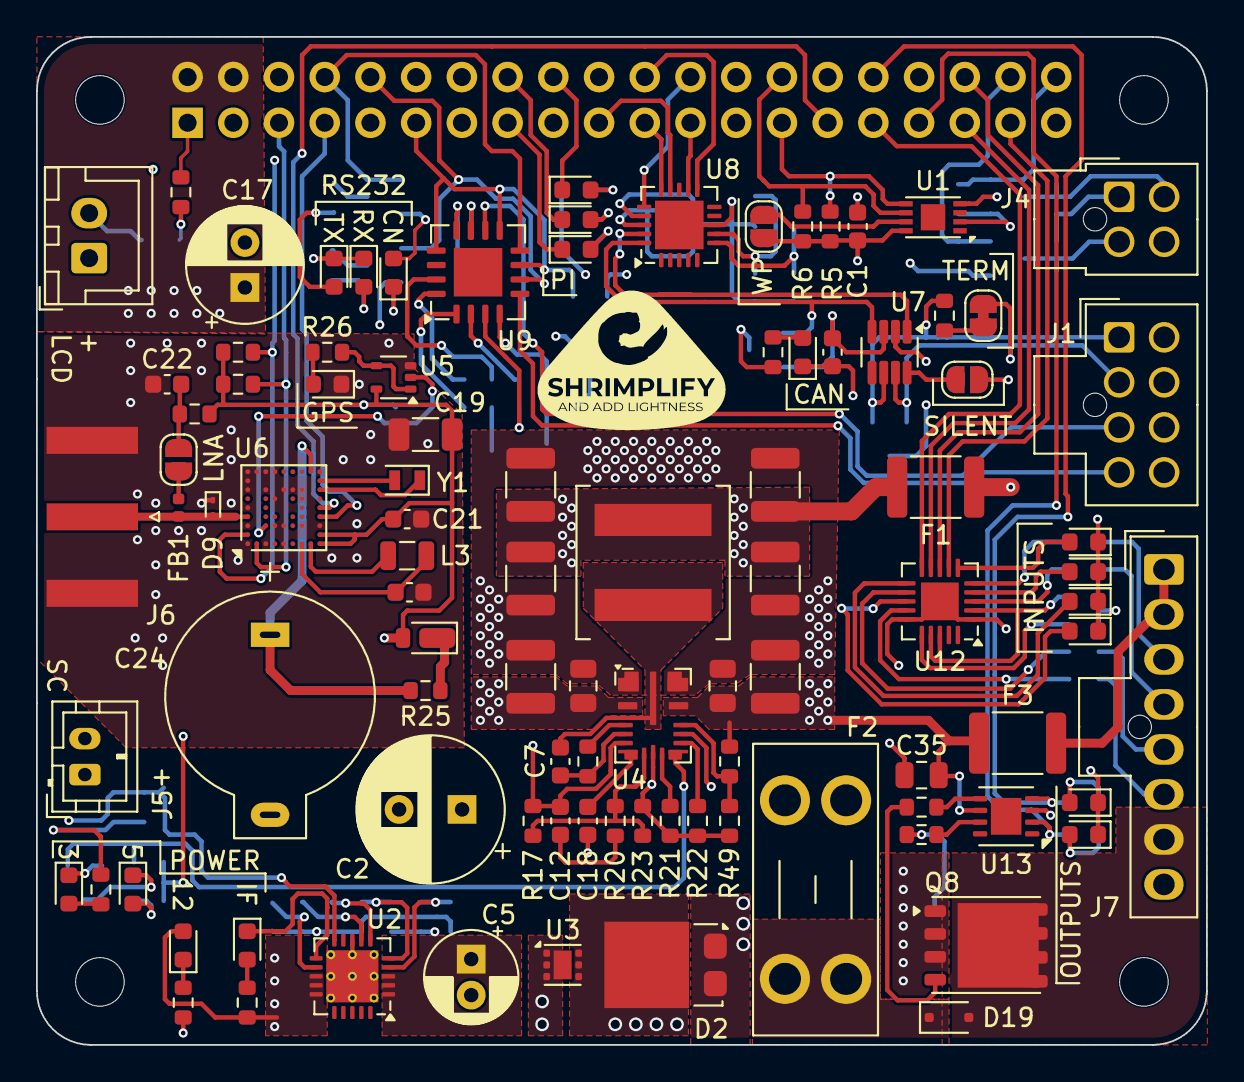
[picture p7: board dashHat.kicad_pcb from above]

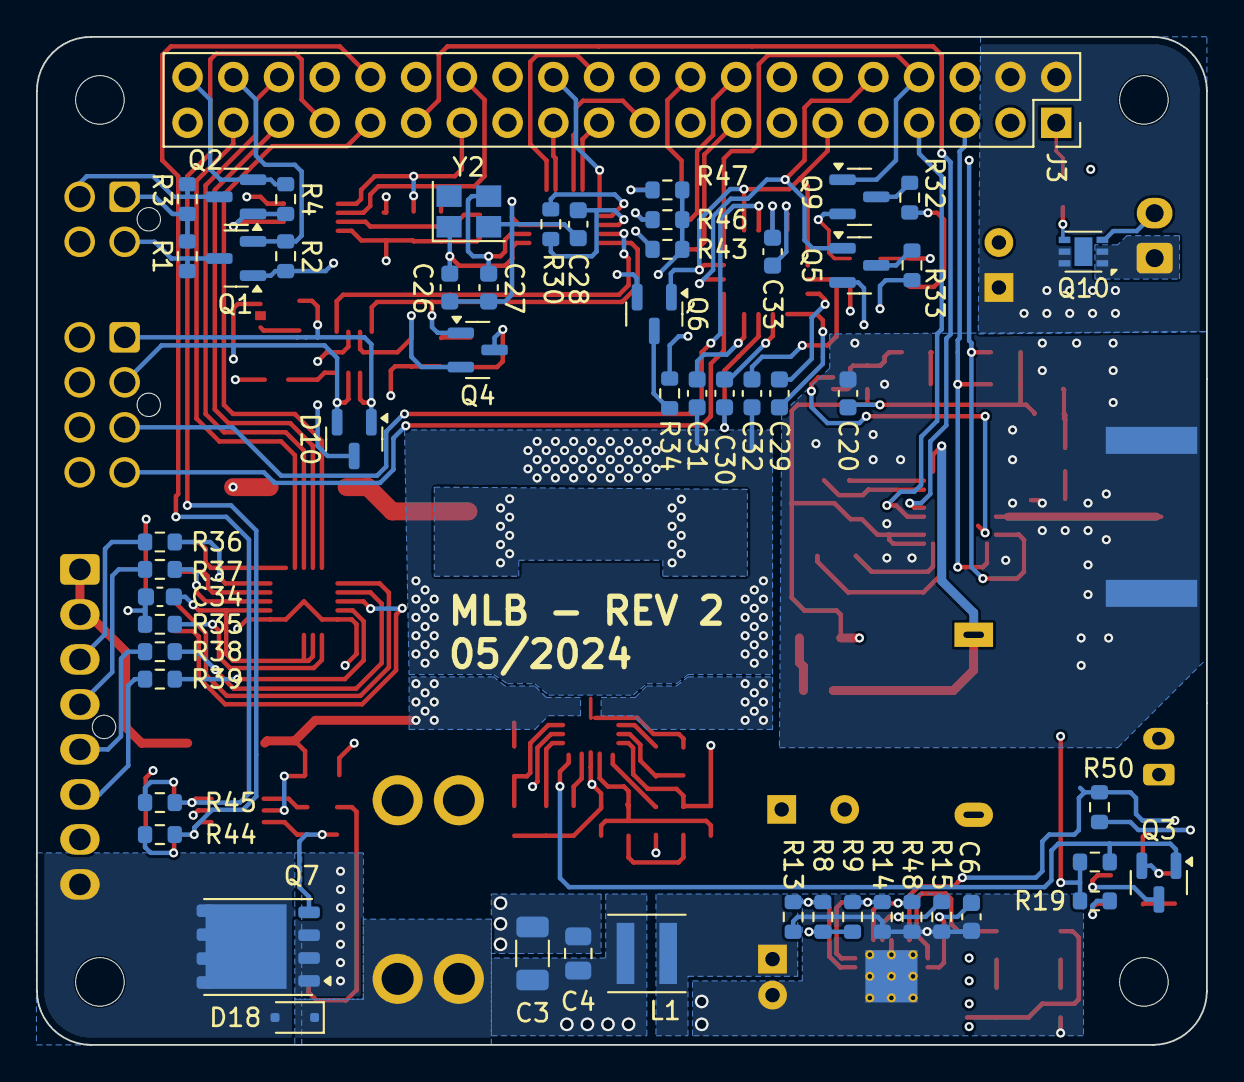
[picture p8: board dashHat.kicad_pcb from below]

Board: 4 copper layers, 65.0 x 56.0 mm, 154 parts (54 on the bottom side), 122 nets.

Other parts of the board:
MH1, MH2, MH3, MH4: MountingHole_2.7mm_M2.5
