michaelyoyo/piDashHat/(threads)

Thread 1 (2024-05-29):

v0.1 Bringup

michaelyoyo, 2024-05-29:
## Tests
- [x] 12v Soft Start
- [x] External Supercap Ridethrough
- [x] 5v Buck Converter
- [x] RS232
- [x] GPS
- [x] CAN
- [x] ID EEPROM
- [x] Addressable LEDs
- [x] IO Connector

## Issues
- [x] BSS84's had a bad Mfg Part Number, none were ordered
- [x] Reverse Polarity Protection didn't work
- [x] U2 OVR/UVR dividers swapped
- [x] L2 has the wrong footprint
- [x] L3, wrong footprint
- [x] D7, wrong footpring
- [x] D4, D5 (input uv, oc) labels are misleading
- [x] J2 (LCD Power) '+' marking is wrong
- [x] Too much voltage drop on 5v trace to pi
- [x] D2 dissipates a lot of power, isn't useful
- [x] Soft Start can get stuck off
- [x] Only 2/4 mounting holes were drilled
- [x] Not enough clearance for cooler on a Pi5
- [x] ID EEPROM should be 0x52, for power hat+
- [x] MAX3226 pinout is completely wrong
- [x] UBlox's I2C is incompatible with Pi4 and older
- [x] Digital Input thresholds were too high
- [x] Output LEDs are swapped
- [x] LED Level Translators have weak pullups
- [x] CAN Controller Pinout is Very Wrong

## Pi5 Changes
- [x] LEDs should be able to run off a secondary hardware spi (SCK, MOSI)
- [x] GPS should be connected to a second UART

Closed 2024-06-22.

Thread 3 (2024-06-22):

v0.2 Bringup

michaelyoyo, 2024-06-22:
## Tests
- [x] 12v Soft Start
- [ ] External Supercap Ridethrough
- [x] 5v Buck Converter
- [ ] RS232
- [x] GPS
- [ ] CAN
- [ ] ID EEPROM
- [x] Addressable LEDs via bit-bang spi
- [ ] Addressable LEDs via hardware spi
- [ ] IO Connector
- [ ] GPS via secondary UART
