michaelyoyo/piDashHat/(commit log)

2024-05-07 added 4 inputs and 2 pwm outputs, completed routing
    [GPIO.kicad_sch, RS232.kicad_sch, can.kicad_sch, dashHat.kicad_pcb, dashHat.kicad_sch, gps.kicad_sch, power.kicad_sch]
2024-05-07 revised schematic after initial layout - all connectors are vertical - increased current handling of outputs - replaced mechanical relay with ssr - jumper to disable gps antenna power
    [GPIO.kicad_sch, RS232.kicad_sch, can.kicad_sch, dashHat.kicad_pcb, dashHat.kicad_sch, gps.kicad_sch, power.kicad_sch]
2024-05-11 second pass at layout complete
    [GPIO.kicad_sch, RS232.kicad_sch, can.kicad_sch, dashHat.kicad_pcb, dashHat.kicad_sch, power.kicad_sch]
2024-05-11 add a version, add uart test pads to gps, sent for manufacturing
    [RS232.kicad_sch, can.kicad_sch, dashHat.kicad_pcb, dashHat.kicad_sch, gps.kicad_sch]
2024-05-12 filled in mfg part number for ordering
    [GPIO.kicad_sch, dashHat.kicad_sch, gps.kicad_sch, power.kicad_sch]
2024-05-12 added missing 3d models, fussed with the silkscreen more
    [dashHat.kicad_pcb, gps.kicad_sch]
2024-05-28 bug fixes from testing
    [GPIO.kicad_sch, RS232.kicad_sch, can.kicad_sch, dashHat.kicad_pcb, dashHat.kicad_sch, gps.kicad_sch, power.kicad_sch]
2024-05-31 fixes from testing, updated for pi5
    [GPIO.kicad_sch, RS232.kicad_sch, can.kicad_sch, dashHat.kicad_pcb, dashHat.kicad_sch, gps.kicad_sch]
2024-05-31 added a switch to the lcd, and feedback from the 12v input to the pi
    [dashHat.kicad_pcb, dashHat.kicad_sch, power.kicad_sch]
2024-05-31 selectable current limit mode
    [dashHat.kicad_pcb, power.kicad_sch]
2024-05-31 fix up silkscreen
    [dashHat.kicad_pcb]
2024-05-31 switch can crystal to 12MHz
    [can.kicad_sch, dashHat.kicad_pcb]
2024-05-31 last tweaks
    [dashHat.kicad_pcb]
2024-06-11 update resistors to more commmon values
    [RS232.kicad_sch, can.kicad_sch, dashHat.kicad_sch, gps.kicad_sch, power.kicad_sch]
2024-06-22 flip logic on rs232 conn led
    [RS232.kicad_sch, dashHat.kicad_pcb]
2024-06-26 remove vf led, add en divider to 5v regulator to fix sequencing
    [dashHat.kicad_pcb, power.kicad_sch]
